AGrock1/Forgotten-Stove-V2/hardware/hardware_wiring.docx

1. Main PCB Pinout & Connection Table

A. ESP32-C3 SuperMini Pin Allocations

ESP32-C3 Pin | Connected Net / Component | Function / Signal | Notes
5V | 5V Rail | Main Power Entry | USB-C input from power supply; feeds RJ45 Pins 1 & 4
3.3V | 3.3V Rail | Regulated Power | Powers RC522 RFID module & I2C pull-ups
GND | GND Rail | System Ground | Common ground pour across the entire PCB
GPIO 0 | RC522 Pin 5 | SPI MISO | Master In, Slave Out
GPIO 2 | RC522 Pin 2 | SPI RST | Hardware Reset
GPIO 3 | Active Buzzer (+) | Digital Output | Active High Alarm trigger
GPIO 4 | Red LED (Anode via R2) | Digital Output | Danger indicator (330 ohm current-limiting resistor to GND)
GPIO 5 | Green LED (Anode via R1) | Digital Output | Safe indicator (330 ohm current-limiting resistor to GND)
GPIO 6 | RC522 Pin 7 | SPI SCK | Serial Clock
GPIO 7 | RC522 Pin 6 | SPI MOSI | Master Out, Slave In
GPIO 8 | RJ45 Pin 3 | I2C SDA | Thermal camera data line (2.2k ohm pull-up R3 to 3.3V)
GPIO 9 | RJ45 Pin 5 | I2C SCL | Thermal camera clock line (2.2k ohm pull-up R4 to 3.3V)
GPIO 10 | RC522 Pin 8 | SPI SS / SDA | Chip Select
GPIO 20 | RJ45 Pin 7 | UART RX (Serial1) | Receives radar data from LD2410 TX
GPIO 21 | RJ45 Pin 8 | UART TX (Serial1) | Transmits radar configuration to LD2410 RX

B. MFRC522 RFID Header (8-Pin Header U2)

Header Pin | Module Pin | Connected Net | Notes
Pin 1 | 3.3V | 3.3V Rail | Don’t connect to 5V!
Pin 2 | RST | ESP32 GPIO 2 | Reset line
Pin 3 | GND | GND Rail | Ground
Pin 4 | IRQ | NC (Unconnected) | Not used in firmware
Pin 5 | MISO | ESP32 GPIO 0 | SPI Data In
Pin 6 | MOSI | ESP32 GPIO 7 | SPI Data Out
Pin 7 | SCK | ESP32 GPIO 6 | SPI Clock
Pin 8 | SDA / SS | ESP32 GPIO 10 | SPI Chip Select

C. RJ45 LAN Bridge Connector (Cat6 Pinout)

RJ45 Pin | Main PCB Origin | Remote PCB Destination | Wire Function
Pin 1 | 5V Rail | Remote 5V Rail | Primary Power Pair
Pin 2 | GND Rail | Remote GND Rail | Primary Ground Pair
Pin 3 | ESP32 GPIO 8 | AMG8833 SDA | I2C Data Line
Pin 4 | 5V Rail | Remote 5V Rail | Secondary Power Pair (Parallel)
Pin 5 | ESP32 GPIO 9 | AMG8833 SCL | I2C Clock Line
Pin 6 | GND Rail | Remote GND Rail | Secondary Ground Pair (Parallel)
Pin 7 | ESP32 GPIO 20 | HLK-LD2410 TX | UART RX
Pin 8 | ESP32 GPIO 21 | HLK-LD2410 RX | UART TX

D. Discrete Passives

Component | Value / Spec | Connection | Function
R1 | 330 ohm1/4W | ESP32 GPIO 5 -> Green LED Anode | Green LED current limit
R2 | 330 ohm1/4W | ESP32 GPIO 4 -> Red LED Anode | Red LED current limit
R3 | 2.2k ohm 1/4W | ESP32 GPIO 8 (SDA) -> 3.3V Rail | I2C SDA Pull-up
R4 | 2.2k ohm 1/4W | ESP32 GPIO 9 (SCL) -> 3.3V Rail | I2C SCL Pull-up
C1 | 100μF 16V Electrolytic | 5V Rail -> GND Rail | Main power buffer
C2 | 100nF Ceramic (104) | 3.3V Rail -> GND Rail | High-frequency noise bypass (RFID)
C3 | 10μF 16V Electrolytic | 3.3V Rail -> GND Rail | Low-frequency voltage sag bypass (RFID)
