AGrock1/Forgotten-Stove-V2/(commit log)

2026-07-06 Create Esp32_C3_code.ino
    Created esp 32 c3 code file
2026-07-09 Implement core thermal and radar safety logic for Forgotten Stove
    Initial working prototype for the Forgotten Stove IoT project running on ESP32-C3.
    Key implementations:
    Integrated AMG8833 thermal camera (I2C) to monitor stove temperatures (temporary threshold: 34.0°C).
    Integrated HLK-LD2410 mmWave radar (UART) for human presence detection.
    Added strict distance gating (max 150cm) to eliminate false positives and room reflections.
    Implemented non-blocking millis() timer for 1Hz thermal sampling while polling radar continuously.
    Created a 3-state hardware alarm system (Safe, Active Cooking, Forgotten Stove) using LEDs and a buzzer.
    [Esp32_C3_code.ino]
2026-07-14 Integrated RFID scanner and Wi-Fi manager
    Added user identification via RC522 RFID module and established stable Wi-Fi connectivity for the ESP32-C3.
    Integrated MFRC522 via hardware SPI to read and hex-format UID tags.
    Implemented non-blocking RFID polling within the main execution loop.
    Added WiFiManager library for dynamic captive-portal Wi-Fi setup without hardcoding credentials.
    Applied critical hardware fix (WiFi.setTxPower(WIFI_POWER_5dBm)) during AP creation and Station mode to prevent voltage regulator brownouts on the ESP32-C3.
    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
    [Esp32_C3_code.ino]
2026-07-27 added firebase cloud sync and dynamic safety timers
    Finalized the core IoT logic for the Forgotten Stove prototype.
    Integrated Firebase_ESP_Client to push real-time sensor data (temperature, distance, cooking status, RFID UID) to the cloud.
    Implemented a cloud to device sync to pull user preference for "grace_period" (Short, Medium, Long) and adjust the non-blocking millis() timer accordingly.
    Refactored sensitive Wi-Fi and Firebase credentials into a git-ignored password.h file to secure the repository.
    Optimized partition scheme to "Huge APP (3MB)" to accommodate the Firebase and WiFiManager libraries.
    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
    [Esp32_C3_code.ino]
2026-07-30 Fixed rfid multi tap bug, optimize Firebase RTDB telemetry, and upgrade sensor wiring to Cat6 lan
    Resolved hardware power drop and software network stability issues in the ESP32-C3 firmware.
    Key changes:
    Migrated long-distance AMG8833 and LD2410 wiring from jumper wires to a Cat6 Ethernet cable, using paired 5V/GND wires to eliminate voltage drop over 3+ meters.
    Switched individual Firebase RTDB pushes to a single FirebaseJson payload via setJSONAsync to eliminate SSL socket buffer crashes (BR_SSL_SENDAPP).
    Isolated Firebase reads (grace_period) and writes using dedicated handles (fbdo_read and fbdo).
    Implemented a non-blocking 1.5s millis() debounce timer (rfid_delay) and PCD_StopCrypt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
    [Esp32_C3_code.ino]
2026-08-11 complete system integration (dashboard, hardware docs, firmware patch)
    - Frontend: Added real-time SPA web dashboard for live sensor monitoring and Firebase auth.
    - Hardware: Added complete PCB wiring documentation and RJ45 Cat6 bridge pinouts.
    - Firmware: Increased Firebase BSSL buffer size (2048/1024) in ESP32 code to prevent connection crashes.
    [Esp32_C3_code.ino]
2026-09-08 Remove RFID integration, add dynamic radar sensitivity, and optimize UI layout
    Removed RFID functionality: Deleted the MFRC522 libraries and hardware scanning loop from the ESP32. Removed the "Last User Tapped" UI card and its associated Firebase listener from the web dashboard.
    Optimized dashboard grid: Added a 2-column span (md:col-span-2) to the Emergency Alerts card to maintain a perfectly balanced, symmetrical UI layout after removing the RFID card.
    Added dynamic radar sensitivity: The ESP32 now actively fetches user sensitivity preferences from Firebase to adjust the maximum detection range (100cm, 150cm, or 250cm).
    Improved radar accuracy: Increased the minimum distance threshold t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
